lchauvin/RedCat51-FlatPanelCover/cad/MotorCase.stl

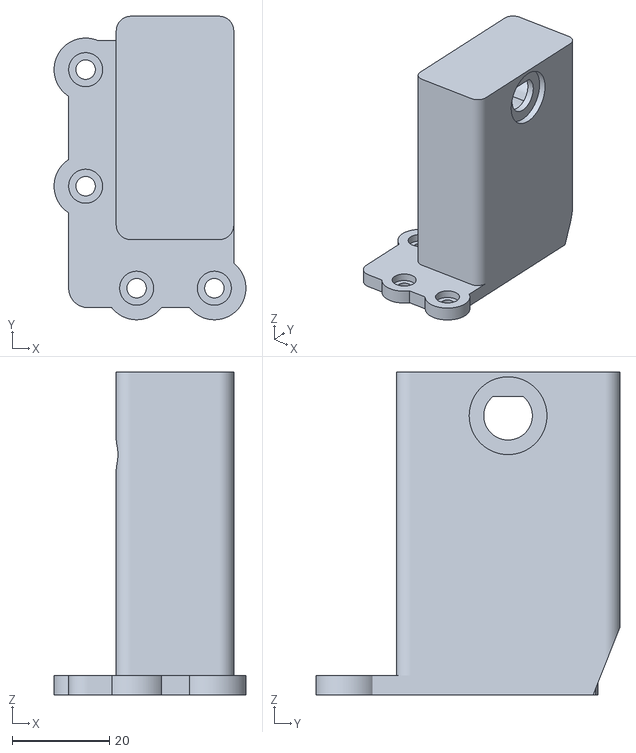
[picture p1: CAD file, 2026-08-06]
cad/MotorCase.stl
39.5 x 62.5 x 66.5
