lchauvin/RedCat51-FlatPanelCover/cad/CaseLid.stl

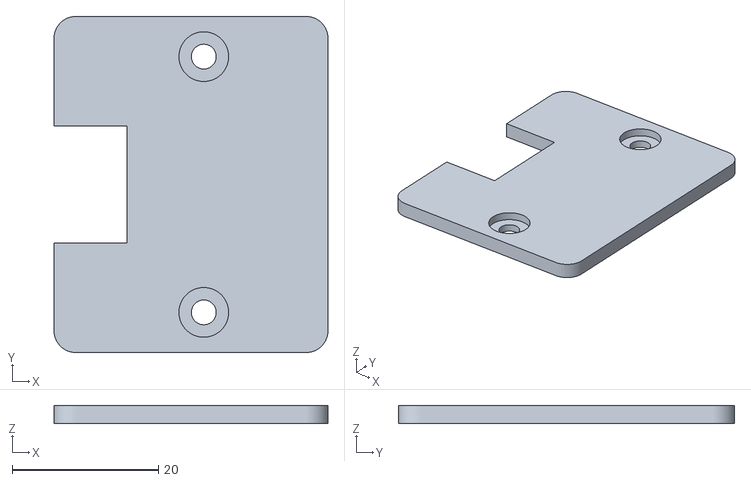
[picture p2: CAD file, 2026-08-06]
cad/CaseLid.stl
37.5 x 46.0 x 2.50
