lchauvin/RedCat51-FlatPanelCover/cad/Seat.stl

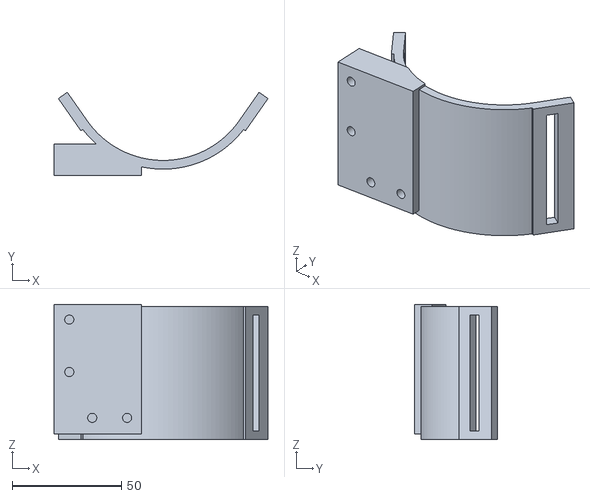
[picture p3: CAD file, 2026-08-06]
cad/Seat.stl
98.0 x 38.2 x 62.0
