lchauvin/RedCat51-FlatPanelCover/cad/LED.stl

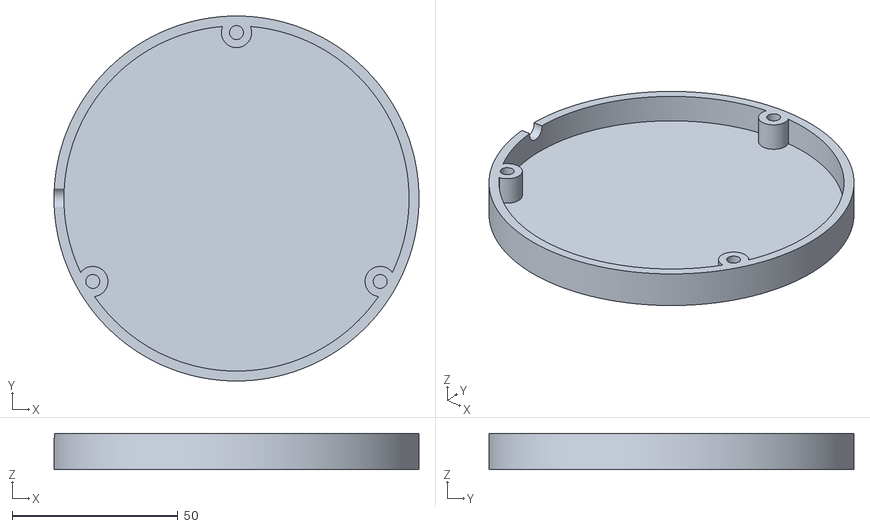
[picture p4: CAD file, 2026-08-06]
cad/LED.stl
110.0 x 110.0 x 11.0
