lchauvin/RedCat51-FlatPanelCover/cad/Arms.stl

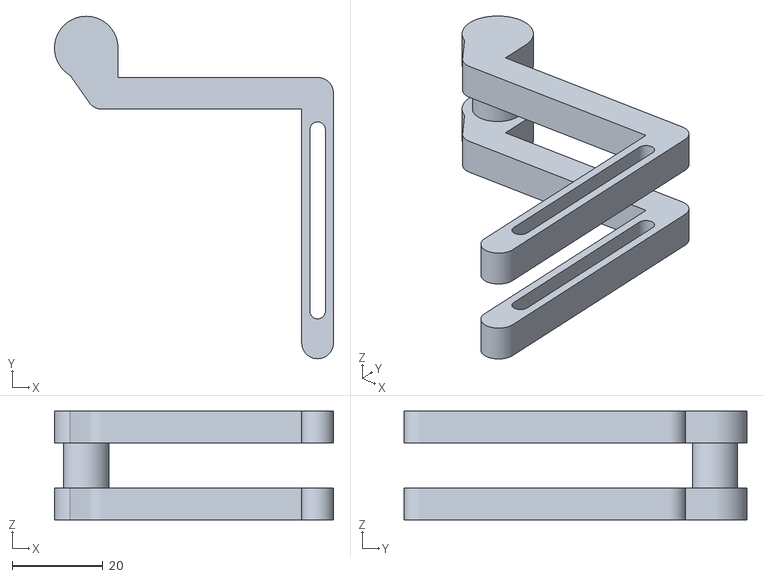
[picture p5: CAD file, 2026-08-06]
cad/Arms.stl
61.5 x 75.5 x 24.0
