lchauvin/RedCat51-FlatPanelCover/cad/PadHolder.stl

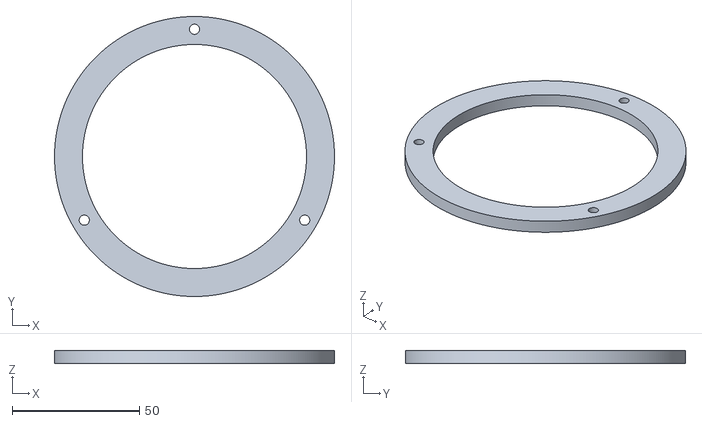
[picture p6: CAD file, 2026-04-17]
cad/PadHolder.stl
110.0 x 110.0 x 5.00
