lchauvin/RedCat51-FlatPanelCover/cad/Diffuser.stl

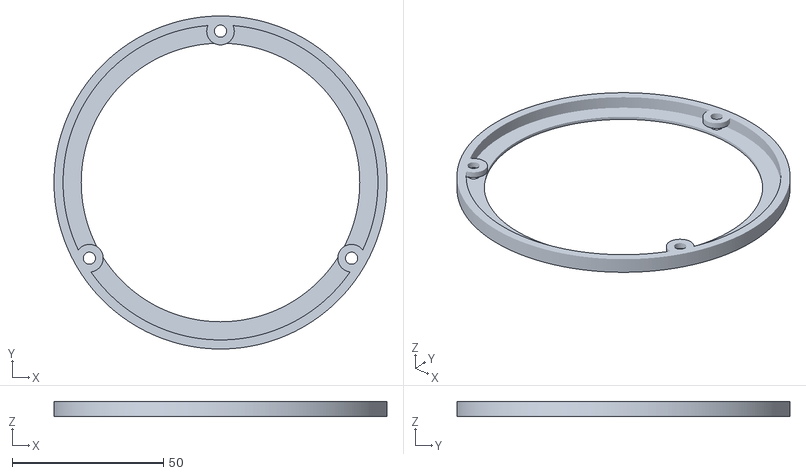
[picture p7: CAD file, 2026-04-17]
cad/Diffuser.stl
110.0 x 110.0 x 5.00
