lchauvin/RedCat51-FlatPanelCover/cad/Gabarit_Diffuser.stl

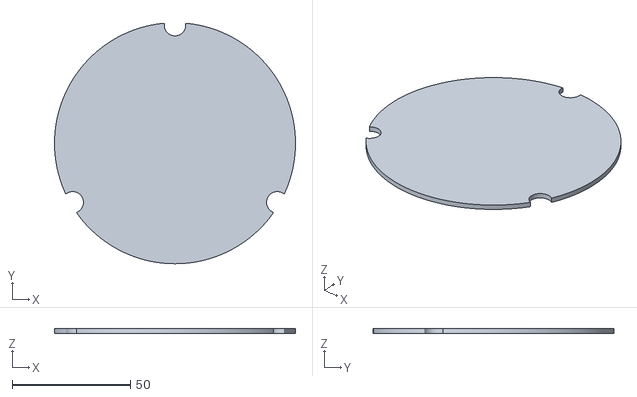
[picture p8: CAD file, 2026-04-17]
cad/Gabarit_Diffuser.stl
102.0 x 101.8 x 2.00
