lchauvin/RedCat51-FlatPanelCover/cad/Gap.stl

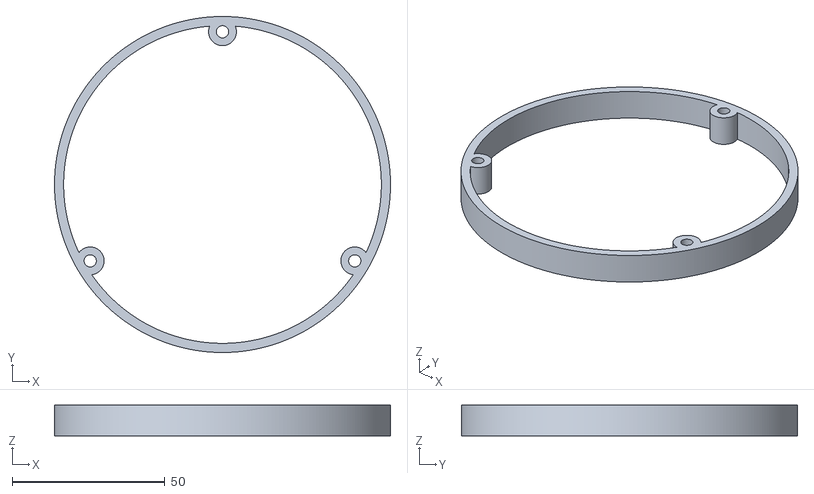
[picture p9: CAD file, 2026-04-17]
cad/Gap.stl
110.0 x 110.0 x 10.0
