lchauvin/RedCat51-FlatPanelCover/(list of files, cad)

Other CAD files:
cad/old/arm.scad
cad/old/flat_panel.scad
cad/old/flat_panel_lid.scad
cad/old/flat_panel_v2 - Copy.scad
cad/old/flat_panel_v2.scad
cad/old/test_panel.scad
