lchauvin/RedCat51-FlatPanelCover/kicad/FlatPanelBoard/FlatPanelBoard/FlatPanelBoard.kicad_pcb

## KiCad design kicad/FlatPanelBoard/FlatPanelBoard/FlatPanelBoard.kicad_pcb (2026-08-13)

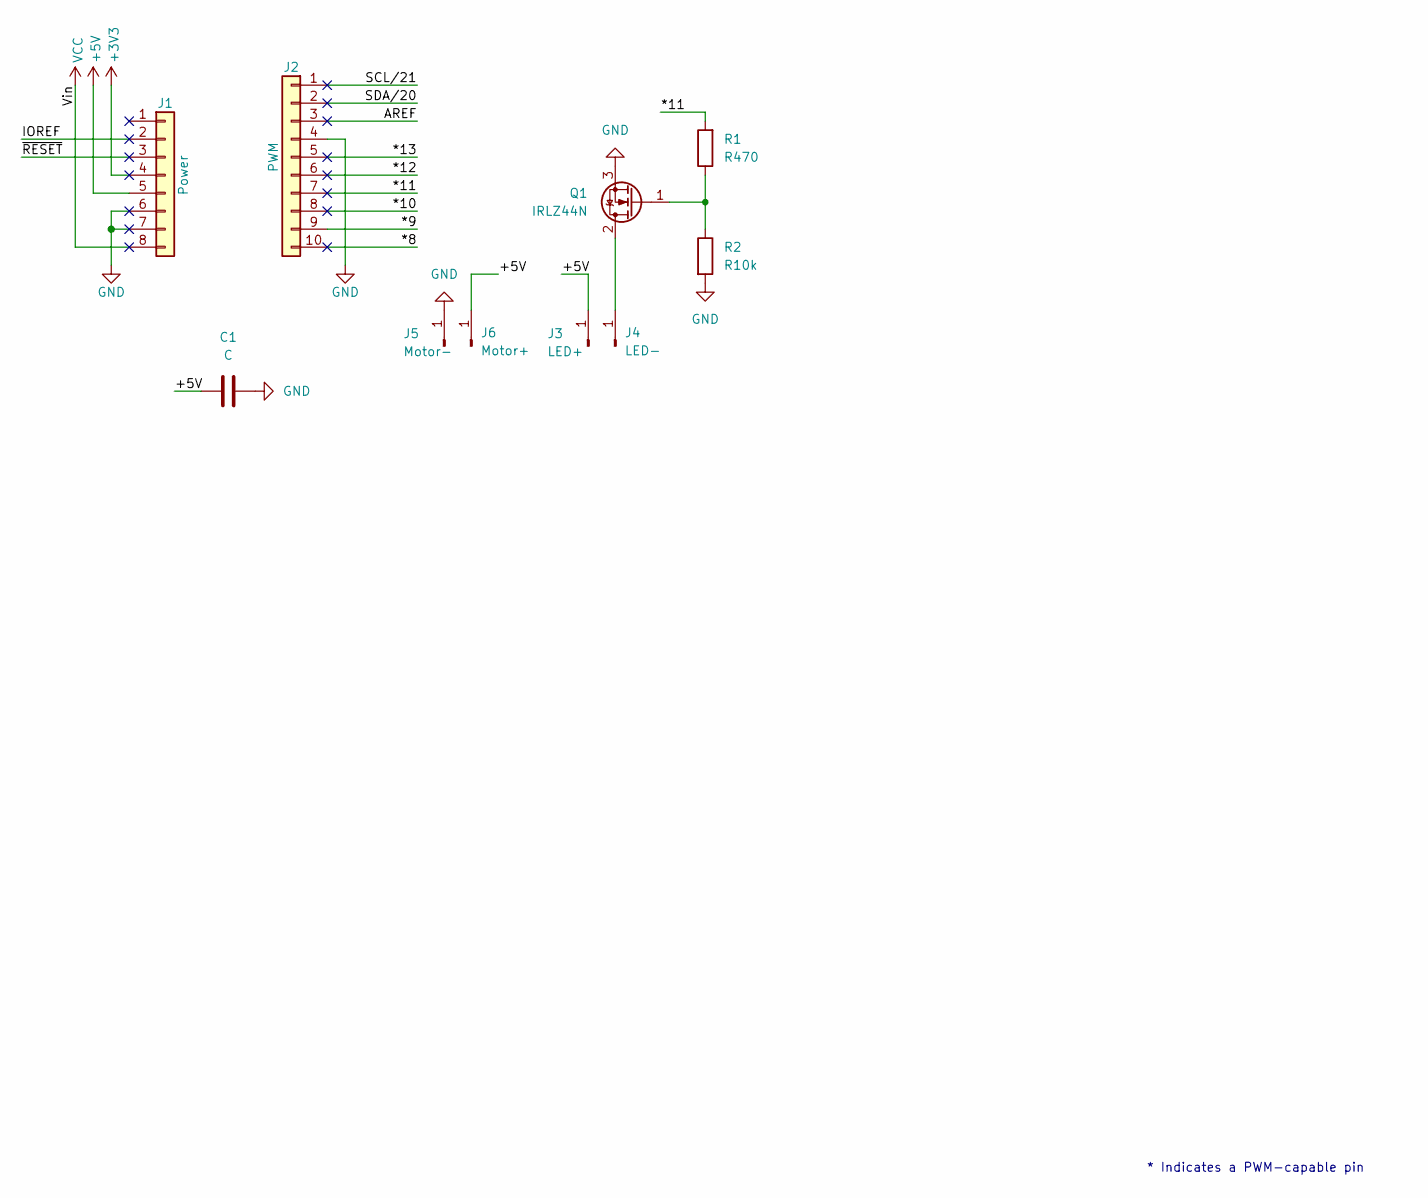
[picture p10: schematic FlatPanelBoard.kicad_sch]

Parts:
C1: C; CP_Radial_D8.0mm_P3.50mm
J1: Power; PinSocket_1x08_P2.54mm_Vertical
J2: PWM; PinSocket_1x10_P2.54mm_Vertical
J3: LED+; Pin_D1.0mm_L10.0mm
J4: LED-; Pin_D1.0mm_L10.0mm
J5: Motor-; Pin_D1.0mm_L10.0mm
J6: Motor+; Pin_D1.0mm_L10.0mm
Q1: IRLZ44N; TO-220-3_Vertical
R1: R470; R_Axial_DIN0207_L6.3mm_D2.5mm_P10.16mm_Horizontal
R2: R10k; R_Axial_DIN0207_L6.3mm_D2.5mm_P10.16mm_Horizontal

Connections:
+3V3: J1.4
+5V: C1.1, J1.5, J3.1 (Pin_1_1), J6.1 (Pin_1_1)
/*8: J2.10
/*9: J2.9
/*10: J2.8
/*11: J2.7, R1.2
/*12: J2.6
/*13: J2.5
/AREF: J2.3
/IOREF: J1.2
/SCL/21: J2.1
/SDA/20: J2.2
/~RESET: J1.3
GND: C1.2, J1.6, J1.7, J2.4, J5.1 (Pin_1_1), Q1.3 (S), R2.2
unnamed: J4.1 (Pin_1_1), Q1.2 (D)
unnamed: Q1.1 (G), R1.1, R2.1
VCC: J1.8

Notes on the sheet:
* Indicates a PWM-capable pin

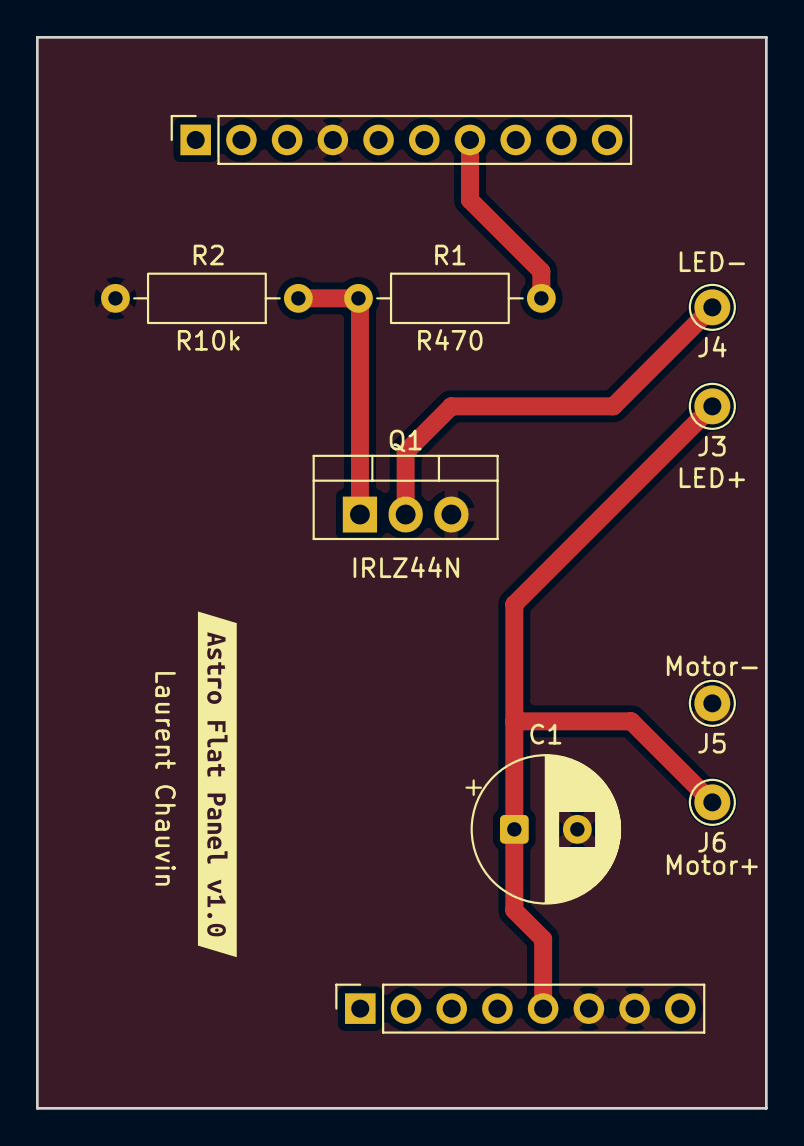
[picture p11: board kicad/FlatPanelBoard/FlatPanelBoard/FlatPanelBoard.kicad_pcb from above]

Board: 2 copper layers, 40.5 x 59.5 mm, 11 parts (0 on the bottom side), 5 nets.

Other parts of the board:
kibuzzard-6A5A3A85: G***; kibuzzard-6A5A3A85
