lchauvin/RedCat51-FlatPanelCover/(commit log)

2026-04-17 Changed for pin 11 on Arduino to allow for finer control of the dimming
2026-08-06 Added kicad circuit
    [Arms.stl, FlatPanelBoard.kicad_pcb, FlatPanelBoard.kicad_sch, LED.stl, flat_panel.scad, stepper.scad]
2026-08-06 Add motor mount and dew-shield seat for the flip cover
    New cad/motor_mount.scad with three printable parts:
    - seat: saddle strapped to the dew shield with velcro (parametric strap
    count/width), slotted ear rails, platform with M3 heat-set inserts.
    Asymmetric along the shield: short nose so the closed panel clears.
    - motor case: 28BYJ-48 housing on a parametric-height riser, offset
    24.5 mm along the hinge so the panel lands on the optical axis.
    Full-depth ear slots key the motor; 2x M3x25 through the flush back
    lid and the motor ears into blind front-wall pilots retain everything.
    - lid: flush back cover with cable notch.
    Assembly preview integrates the real linkage arms and a pane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
    [CaseLid.stl, MotorCase.stl, Seat.stl, flat_panel.scad, motor_mount.scad]
2026-08-07 Separated arms from other files
    [arms.scad, flat_panel.scad, motor_mount.scad]
2026-08-07 Added a securing screw hole in the arm. Tried to create case for Arduino Mega. Not very successful. Maybe the case should be moved on the seat or somewhere else.
    [arms.scad, flat_panel.scad, motor_mount.scad]
2026-08-08 Updated motor case
    [motor_mount.scad]
2026-08-13 Updated cad file and kicad to connect to pin 11 instead of pin 9
    [FlatPanelBoard.kicad_pcb, FlatPanelBoard.kicad_sch, arms.scad, flat_panel.scad, motor_mount.scad]
